timvideos/HDMI2USB-TOFE-adapters/README.md

# TOFE Adapter and Riser Boards

This repository contains designs for **passive** adapter and riser boards for
used with the TOFE interface.

These adapter boards are **transparent** to the TOFE bus and have identical
schematics, only the PCB design differs.

Any **passive** PCI-Express adapter or riser which meets the PCI-Express
specification should be also compatible with the TOFE interface (but the
reverse is not necessarily true).

For [more information on the TOFE interface, see the HDMI2USB website](http://hdmi2usb.tv/tofe).
See the [KiCad website](http://kicad.org/) for more information on using it.

More information about each board can be found in each directory.

# [Left Angle Adapter](left-angle)

Left angle adapter to allow TOFE boards to be mounted horizontally above the
Opsis board.

These adapters where shipped as a bonus to crowd funding backers who purchased
an Opsis board and a TOFE expansion board.

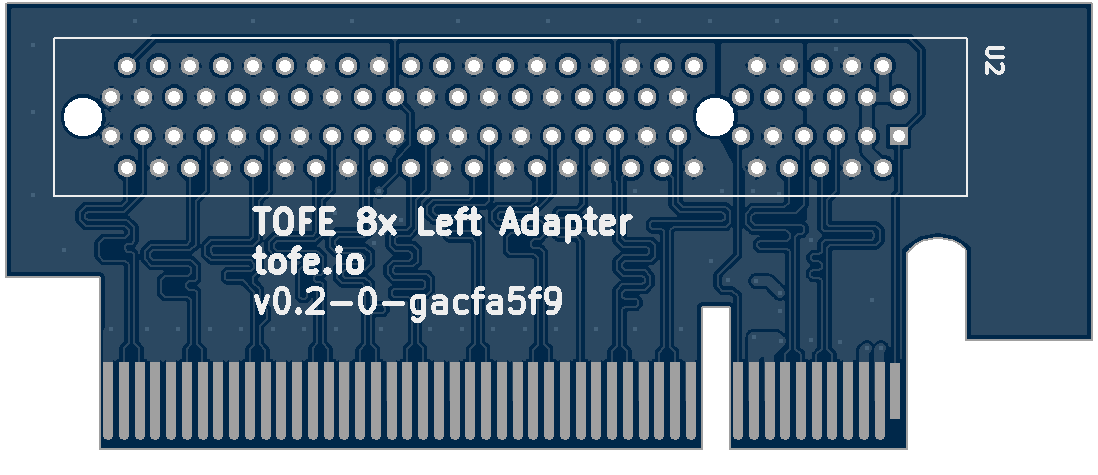
[picture p1: left-angle/img/tofe-left-angle.png]
gerberlook.org render of left-angle adapter


# [Vertical](vertical)

Adapter which uses a "straddle edge connector" to raise a board vertically.

# [Male to Male](male-to-male)

Adapter which has TOFE pins on both sides allowing two boards with TOFE sockets
be connected together.

FIXME: Put image here.

## Editing

The designs in this repository was made using
[KiCad](http://www.kicad.org/) version **4.0.2**.

## License

This work is copyright Numato Systems Pvt. Ltd 2015 and licensed under a
Creative Commons Attribution-ShareAlike 4.0 International License.

You should have received a copy of the license along with this
work.  If not, see <http://creativecommons.org/licenses/by-sa/4.0/>.
