timvideos/HDMI2USB-TOFE-adapters/male-to-male/README.md

 * 2 layer board
 * 6mil traces / 6mil clearance
 * 12mil drill / 24mil vias (0.3mm drill / 0.6mm vias)

Length matching

 * ???
