timvideos/HDMI2USB-TOFE-adapters/schematic/TOFEAdapter.sch

## KiCad design schematic/TOFEAdapter.sch (2016-08-01, an earlier design)

Schematic: TOFEAdapter.sch

Parts:
U1, U2: TOFE-8X
