timvideos/HDMI2USB-TOFE-adapters/(commit log)

2015-11-04 Initial schematic version.
    [TOFEAdapter.sch]
2015-11-04 Fixing for the library part fix.
    [TOFEAdapter.sch]
2015-11-04 Adding the left-angle adapter.
    [TOFEAdapter.kicad_pcb, TOFEAdapter.sch]
2015-11-04 Fixing text.
    [TOFEAdapter.kicad_pcb]
2016-06-18 Removing unneeded libraries.
    [TOFEAdapter.sch]
2016-06-18 Removing text.
    [TOFEAdapter.sch]
2016-06-18 Updating the .net file.
    [TOFEAdapter.sch]
2016-06-18 Line ending conversion.
    [TOFEAdapter.kicad_pcb, TOFEAdapter.sch]
2016-06-18 Updating to new kicad version.
    [TOFEAdapter.kicad_pcb]
2016-06-18 Updating the pins from the part library.
    [TOFEAdapter.kicad_pcb]
2016-06-18 Starting a male-to-male adapter.
    [TOFEAdapter.sch]
2016-06-18 Adding PCB file for male-to-male adapter.
    [TOFEAdapter.kicad_pcb]
2016-06-22 Adding gerber files used in production.
    [left-angle-B_Cu.gbl, left-angle-B_Mask.gbs, left-angle-B_SilkS.gbo, left-angle-Edge_Cuts.gbr, left-angle-F_Cu.gtl, left-angle-F_Mask.gts, left-angle-F_SilkS.gto, left-angle-NPTH.drl]
2016-08-01 Tweaking for easier production.
    [TOFEAdapter.kicad_pcb]
2016-08-01 Changing to 0.6mm vias.
    [TOFEAdapter.kicad_pcb]
2016-08-01 Fixing for DRC from larger vias.
    [TOFEAdapter.kicad_pcb]
2016-08-01 Making sure everything is connected and pass the DRC.
    [TOFEAdapter.kicad_pcb]
2016-08-01 Make the vias line up.
    [TOFEAdapter.kicad_pcb]
2016-08-01 Small updates to zones and vias.
    [TOFEAdapter.kicad_pcb]
2016-08-01 Updating the output a bit.
    [TOFEAdapter.kicad_pcb]
2016-08-01 Small updates.
    [TOFEAdapter.kicad_pcb]
2016-08-01 Moving the gerbers around.
    [left-angle-B_Cu.gbl, left-angle-B_Mask.gbs, left-angle-B_SilkS.gbo, left-angle-Edge_Cuts.gbr, left-angle-F_Cu.gtl, left-angle-F_Mask.gts, left-angle-F_SilkS.gto, left-angle-NPTH.drl]
2016-08-01 Moving the ID to it's own gr_text.
    [TOFEAdapter.kicad_pcb]
2016-08-01 Fixing width of edge cut.
    [TOFEAdapter.kicad_pcb]
2016-08-01 Use $Desc$ as $Id$ gets actually replaced by git.
    [TOFEAdapter.kicad_pcb]
2016-08-01 Making the edge cuts a little thicker.
    [TOFEAdapter.kicad_pcb]
2016-08-01 Creating gerbers v0.2-0-gacfa5f9 for left-angle
    [TOFEAdapter-CuBottom.gbl, TOFEAdapter-CuTop.gtl, TOFEAdapter-EdgeCuts.gm1, TOFEAdapter-MaskBottom.gbs, TOFEAdapter-MaskTop.gts, TOFEAdapter-NPTH.drl, TOFEAdapter-PasteBottom.gbp, TOFEAdapter-PasteTop.gtp]
2016-08-01 Starting to route the male-to-male adapter.
    [TOFEAdapter.kicad_pcb]
2016-08-01 Giving the nets names which KiCad understands.
    [TOFEAdapter.sch]
2016-08-01 Lots of work to make male-to-male adapter work.
    [TOFEAdapter.kicad_pcb]
2016-08-02 Fixing wrong type of board.
    [TOFEAdapter.kicad_pcb, TOFEAdapter.sch]
2016-08-02 Fixing the naming a little.
    [TOFEAdapter.kicad_pcb]
2016-08-02 Restoring the male-to-male adapter.
    [TOFEAdapter.kicad_pcb, TOFEAdapter.sch]
2016-08-02 Started routing and fixing the footprint.
    [TOFEAdapter.kicad_pcb]
2016-08-02 More updates.
    [TOFEAdapter.kicad_pcb]
2016-08-02 Lots of stuff.
    [TOFEAdapter.kicad_pcb]
2016-08-03 Removing soldermask from pins.
    [TOFEAdapter.kicad_pcb]
2016-08-03 Another attempt.
    [TOFEAdapter.kicad_pcb]
2016-08-03 Creating gerbers v0.2-14-g2711d69 for left-angle
    [TOFEAdapter-CuBottom.gbl, TOFEAdapter-CuTop.gtl, TOFEAdapter-EdgeCuts.gm1, TOFEAdapter-MaskBottom.gbs, TOFEAdapter-MaskTop.gts, TOFEAdapter-NPTH.drl, TOFEAdapter-PasteBottom.gbp, TOFEAdapter-PasteTop.gtp]
2016-10-01 male-to-male: Routed version of board.
    [TOFEAdapter.kicad_pcb]
2016-10-03 Adding extra tie vias.
    [TOFEAdapter.kicad_pcb]
2016-10-13 Adding silkscreen stuff.
    [TOFEAdapter.kicad_pcb]
2016-10-15 Fixing the board edge.
    [TOFEAdapter.kicad_pcb]
2016-10-15 Don't put soldermask on pin areas.
    [TOFEAdapter.kicad_pcb]
2016-10-15 Move soldermask down a little.
    [TOFEAdapter.kicad_pcb]
2016-10-15 Adding lines on both sides.
    [TOFEAdapter.kicad_pcb]
2016-10-15 Adding OSHW logo and fixing line.
    [TOFEAdapter.kicad_pcb]
2016-10-15 Creating gerbers v0.2-26-gac2b58b for male-to-male
    [TOFEAdapter-CuBottom.gbl, TOFEAdapter-CuTop.gtl, TOFEAdapter-EdgeCuts.gm1, TOFEAdapter-MaskBottom.gbs, TOFEAdapter-MaskTop.gts, TOFEAdapter-PasteBottom.gbp, TOFEAdapter-PasteTop.gtp, TOFEAdapter-SilkBottom.gbo]
2021-11-10 Update README.md
    https://forum.kicad.info/t/warning-avoid-all-links-to-kicad-pcb-org-use-kicad-org/31521
