timvideos/HDMI2USB-TOFE-adapters/(notices)

Notices in the files:
schematic/TOFEAdapter.sch:
License : CC BY-SA
